JohnPattersonConsulting/DuneBuggyEFI/soupflood's 555-Based Gate Driver.jpg

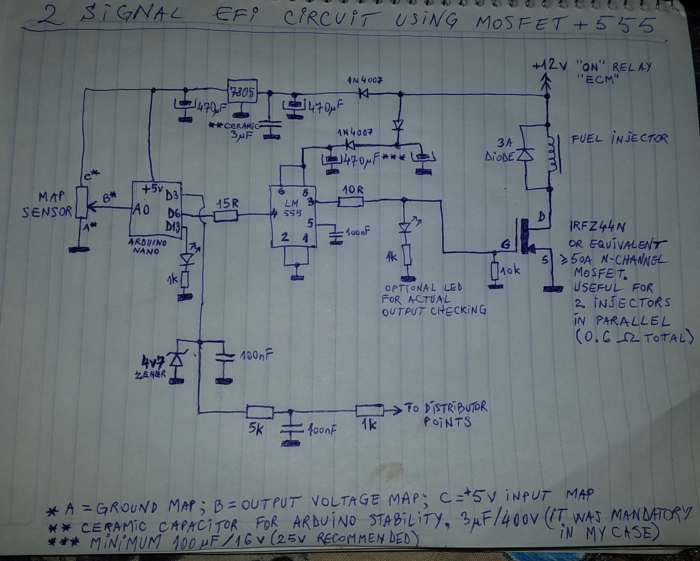
soupflood's 555-Based Gate Driver.jpg
