JohnPattersonConsulting/DuneBuggyEFI/EFI+Ignition/PCB Files/Power_Buggy_ECU_V3.1_Preview.jpg

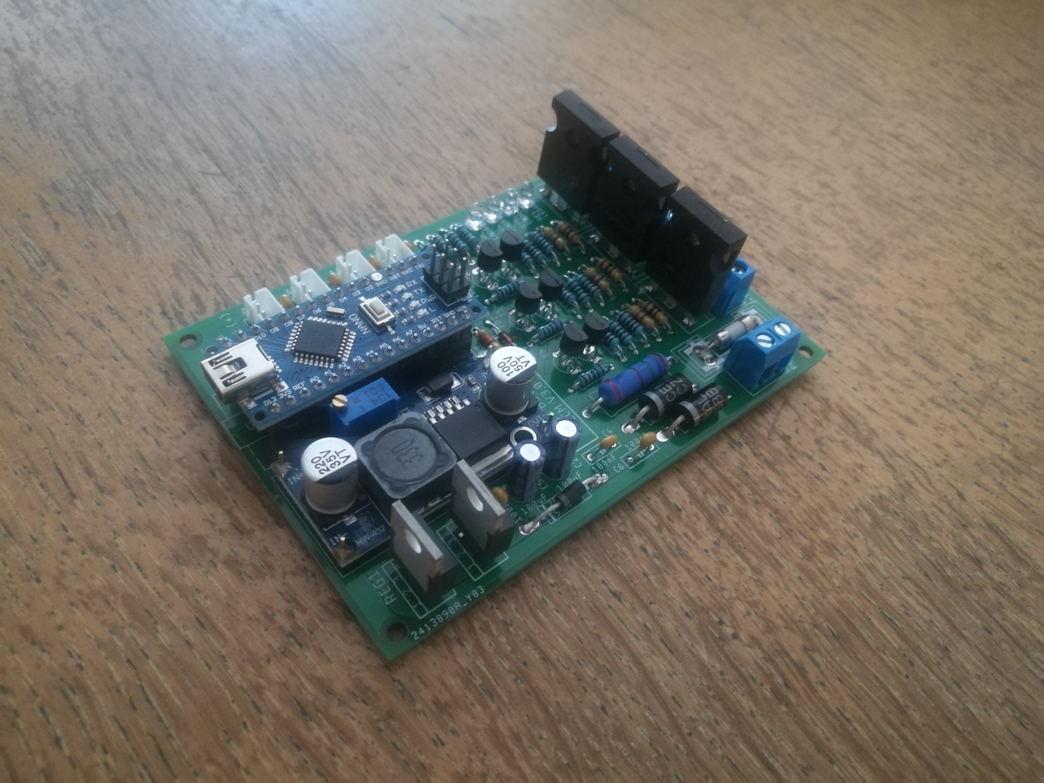
EFI+Ignition/PCB Files/Power_Buggy_ECU_V3.1_Preview.jpg
