JohnPattersonConsulting/DuneBuggyEFI/4-Coil_ECM/PCB Files/BOM_4-Coil_V1.1.xlsx

Engine Control Module Parts:
Description: | MFG Part #: | QTY:
CAP CER 0.1UF 50V Z5U RADIAL | C315C104M5U5TA7303 | 8
IC REG LINEAR 5V 1A TO220-3 | LM7805CT/NOPB | 2
CAP ALUM 100UF 20% 16V RADIAL | ESL107M016AC3AA | 2
DIODE ZENER 22V 5W AXIAL | 1N5358BG | 2
MOSFET N-CH 500V 20A TO247-3 | IRFP460 | 6
TRANS PNP 40V 0.2A TO92 | 2N3906-G | 4
T-NPN SI-GEN PUR AMP SW | 2N4401 | 4
RES 100 OHM 1/4W 5% CF MINI | CFM14JT100R | 6
RES 470 OHM 1/4W 5% AXIAL | CF14JT470R | 4
RES 1K OHM 1/4W 1% AXIAL | RNF14FTD1K00 | 23
RES 3.3K OHM 1/4W 5% AXIAL | CF14JT3K30 | 4
CONN HEADER VERT 3POS 2MM | SWR201-NRTN-S03-SA-WH | 3
DIODE ZENER 4.7V 400MW ALF2 | BZX79-C4V7,133 | 4
400KHz 60V 4A Switching Current Boost / Buck-Boost / Inverting DC/DC Converter | XL6009E1 | 1
LED BLUE CLEAR T/H | LTL1CHTBK4 | 2
LED GREEN CLEAR T-1 T/H | LTL1CHKGKNN | 2
LED RED CLEAR T-1 T/H | LTL1CHKRKNN | 2
LED YELLOW CLEAR T-1 T/H | LTL1CHKSKNN | 1
RES 10K OHM 5% 1/4W AXIAL | CF14JT10K0 | 4
DIODE ZENER 5.6V 3W AXIAL | 1N5919BG | 1
FUSE CERAMIC 8A 250VAC AXIAL | C310T-SC-8-R-TR1 | 1
ARDUINO NANO | ARDUINO NANO | 2
CAP CER 10000PF 50V X7R RADIAL | K103K10X7RF5UH5 | 4
EURO BLOCK, 2 POSITION | EBBA-02-C-SS-BU | 9
Optical Spark Board Parts:
Description: | MFG Part #: | QTY:
TRANS NPN 30V 0.8A TO18 | 2N2222 | 4
Slot PCB Photo Interrupter | HY860F | 2
RES 3.3K OHM 5% 1/4W AXIAL | CF14JT3K30 | 5
RES 470 OHM 1W 5% AXIAL | PR01000104700JR500 | 4
CAP CER 1UF 25V X5R RADIAL | FK18X5R1E105K | 1
