JohnPattersonConsulting/DuneBuggyEFI/EFI+Ignition/PCB Files/BOM_Power_Buggy_EFI_V3.1.xlsx

Engine Control Module Parts:
Description: | MFG Part #: | QTY:
CAP CER 0.1UF 50V Z5U RADIAL | C315C104M5U5TA7303 | 9
IC REG LINEAR 5V 1A TO220-3 | LM7805CT/NOPB | 2
CAP ALUM 100UF 20% 16V RADIAL | ESL107M016AC3AA | 2
DIODE ZENER 22V 5W AXIAL | 1N5358BG | 2
MOSFET N-CH 500V 20A TO247-3 | IRFP460 | 3
TRANS PNP 40V 0.2A TO92 | 2N3906-G | 3
T-NPN SI-GEN PUR AMP SW | 2N4401 | 3
RES 100 OHM 1/4W 5% CF MINI | CFM14JT100R | 3
RES 470 OHM 1/4W 5% AXIAL | CF14JT470R | 3
RES 1K OHM 1/4W 1% AXIAL | RNF14FTD1K00 | 16
RES 3.3K OHM 1/4W 5% AXIAL | CF14JT3K30 | 1
CONN HEADER VERT 3POS 2MM | SWR201-NRTN-S03-SA-WH | 4
DIODE ZENER 4.7V 400MW ALF2 | BZX79-C4V7,133 | 1
400KHz 60V 4A Switching Current Boost / Buck-Boost / Inverting DC/DC Converter | XL6009E1 | 1
RES 150 OHM 2% 2W AXIAL | RSF2GT150R | 1
LED BLUE CLEAR T/H | LTL1CHTBK4 | 1
LED GREEN CLEAR T-1 T/H | LTL1CHKGKNN | 1
LED RED CLEAR T-1 T/H | LTL1CHKRKNN | 1
LED YELLOW CLEAR T-1 T/H | LTL1CHKSKNN | 1
RES 10K OHM 5% 1/4W AXIAL | CF14JT10K0 | 1
DIODE ZENER 5.6V 3W AXIAL | 1N5919BG | 1
FUSE CERAMIC 8A 250VAC AXIAL | C310T-SC-8-R-TR1 | 1
ARDUINO NANO | ARDUINO NANO | 1
Suggested Mechanical Parts:
Description: | Source:
Fuel Injector Barb Adapter | https://www.ebay.com/itm/113711584424
440 cc/min Fuel Injectors | https://www.ebay.com/itm/223283676528
MAP Sensor | https://www.amazon.com/gp/product/B07Z37XG1J
Fuel Filter/Pressure Regulator | https://www.amazon.com/gp/product/B07W9H5TF9
Fuel Pump | https://www.amazon.com/gp/product/B07J39HNTC
Fuel Hose | https://www.amazon.com/gp/product/B00PLKV5H6
High-Energy Ignition Coil (Sold as pack of 8, but only need 1) | https://www.amazon.com/gp/product/B00EOXZLG2
