JohnPattersonConsulting/DuneBuggyEFI/4-Coil_ECM/Distributor Cover Cap/Buggy_Distributor_Cover_V1.STEP

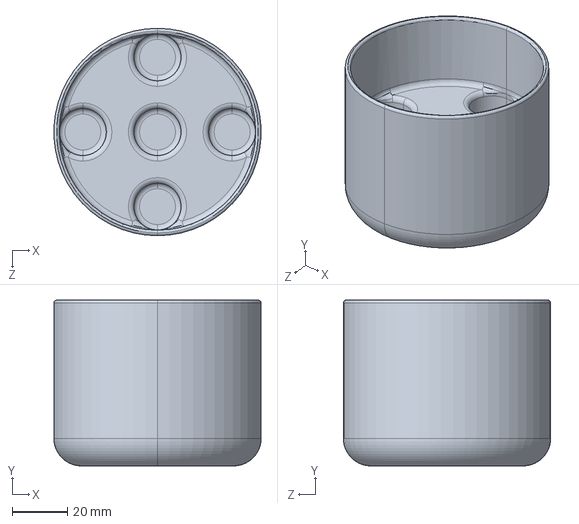
[picture p3: CAD file, 2022-07-23]
4-Coil_ECM/Distributor Cover Cap/Buggy_Distributor_Cover_V1.STEP
74.9 x 60.0 x 75.0 mm
