JohnPattersonConsulting/DuneBuggyEFI/4-Coil_ECM/Optical Rotor CAD/Optical_Rotor.STEP

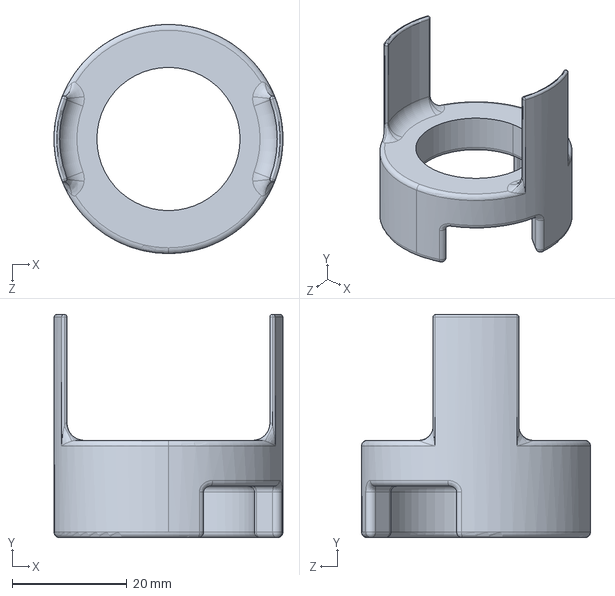
[picture p4: CAD file, 2022-06-12]
4-Coil_ECM/Optical Rotor CAD/Optical_Rotor.STEP
40.0 x 39.0 x 40.0 mm
