JohnPattersonConsulting/DuneBuggyEFI/(list of files, cad)

Other CAD files:
4-Coil_ECM/Distributor Cover Cap/Buggy_Distributor_Cover_V1.SLDPRT
4-Coil_ECM/Distributor Cover Cap/Buggy_Distributor_Cover_V1.STL
4-Coil_ECM/Optical Rotor CAD/Optical_Rotor.SLDPRT
4-Coil_ECM/Optical Rotor CAD/Optical_Rotor.STL
