JohnPattersonConsulting/DuneBuggyEFI/(threads)

Thread 2 (2022-04-26):

Piggyback mode

giannaros900, 2022-04-26:
Very good job but how about a piggyback mode for 2 cylinder RPM vs TPS vs AFR??? Would be very interested for motorcycles

soupflood, 2023-04-01:
Assuming the 2 cylinder engine is a 4 stroke, it will send 1 pulse per revolution, so modify pulsesPerRevolution = 1. "fuel_comp = 1" for regular gasoline, just remove the double dash ”//” to activate the constant and add double dash in front of the other "fuel_comp" to inactivate it.
Next, find your injector maximum flow rate in g/min and input it in "injector_Max_Grams_Per _Minute"constant. Then, choose a refresh rate for the injector in "injector_UpdateInterval". 30000 to 50000 may work okay.
In the version 2.1, TPS is emulated in the code (less wiring, less complex build) and you can choose one of the various AFR maps provided (default is "Richer at idle only").

giannaros900, 2023-04-01:
The problem with piggyback mode is when dfco is activated...the injectors are completely closed and we can't calculate rpm.... so,crankshaft position signal is necessary, that means we need 3 interrupts

soupflood, 2023-04-01:
That sounds quite a bit more complicated than the purpose of the original code. If you want to, you could learn to modify it in order to comply with the DFCO function you wish.

Thread 4 (2023-03-31):

2 signal EFI circuit using MOSFET + 555

soupflood, 2023-03-31:
I built an EFI circuit using your electronic schematic, only I used a MOSFET driven by a TL555 in the gate buffer mode.
I would like to send you the schematic I used for you to post it along with your original one, so that other people can also use it if they want. I already tested the circuit and it works okay.
Let me know what you think.
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

JohnPattersonConsulting, 2023-04-01:
This is a great idea! One suggestion I would have would be to put some kind
of regulator on the power supply of the 555, as I have blown up many 555s
by connecting them directly to the automotive 12V rail.

Are you able to submit it as a fork or commit, or do I have to upload it
directly?

Best regards,
John

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

soupflood, 2023-04-01:
I don't know yet how to upload images the way you said; and I only have the image I attached. If you think the quality is good, then please upload it next to your original schematic.
About the 555: yes, it would be ideal to feed it through a proper 12V regulator, however I don't currently have one laying around. The series double diode - parallel double capacitor seems to have done the trick so far because it still works okay. The 555 is supposed to handle up to 15V of VCC, but if it will blow up I will of course consider getting one 12V regulator installed.
I guess every car wiring is different; I rather had more problems with the Arduino stability than with the 555: had to solder a 3uF ceramic capacitor across the 5V regulator input's electrolytic capacitor, and replace the 10k resistor leading to the points with a 5k one (just soldered another 10k in parallel to it).

JohnPattersonConsulting, 2023-04-02:
Excellent, I just uploaded your design.

By the way, one thing that I found to work well was to add a piece of
copper mesh or foil over the top of the ATMega328p and its clock crystal,
and to solder this part to the USB port for grounding. After I did this,
the Arduino Nano was much more stable and gave less trouble with crashing.

I also removed the small 5V regulator on the back of the Nano, as I found
that after a couple months of driving, it randomly started short-circuiting
the 5V rail.

Best regards,
John

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

soupflood, 2023-04-02:
Thank you for uploading it.
What I found to be useful so far, was to keep all Arduino related wires at
least one inch away from any spark wires. I guess that even if I screen it
like you suggested, it will still be bothered if its wires come too close
to the high voltage parts.
As far as the on board 5v regulator...I really hope it won't go bad because
I'm not even actually using it... And I've already soldered the Arduino
board to the "mother"board.
Take care.

El sáb., 1 de abr. de 2023 8:08 p. m., JohnPattersonConsulting <
***@***.***> escribió:

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

DANAVERYOLD, 2025-09-05:
Where is the code for nano is one of the listed
