JohnPattersonConsulting/DuneBuggyEFI/4-Coil_ECM/PCB Files/Optical_Spark_V2.0/Optical_Spark_V2.0.brd

## EAGLE design 4-Coil_ECM/PCB Files/Optical_Spark_V2.0/Optical_Spark_V2.0.brd (2022-05-30)

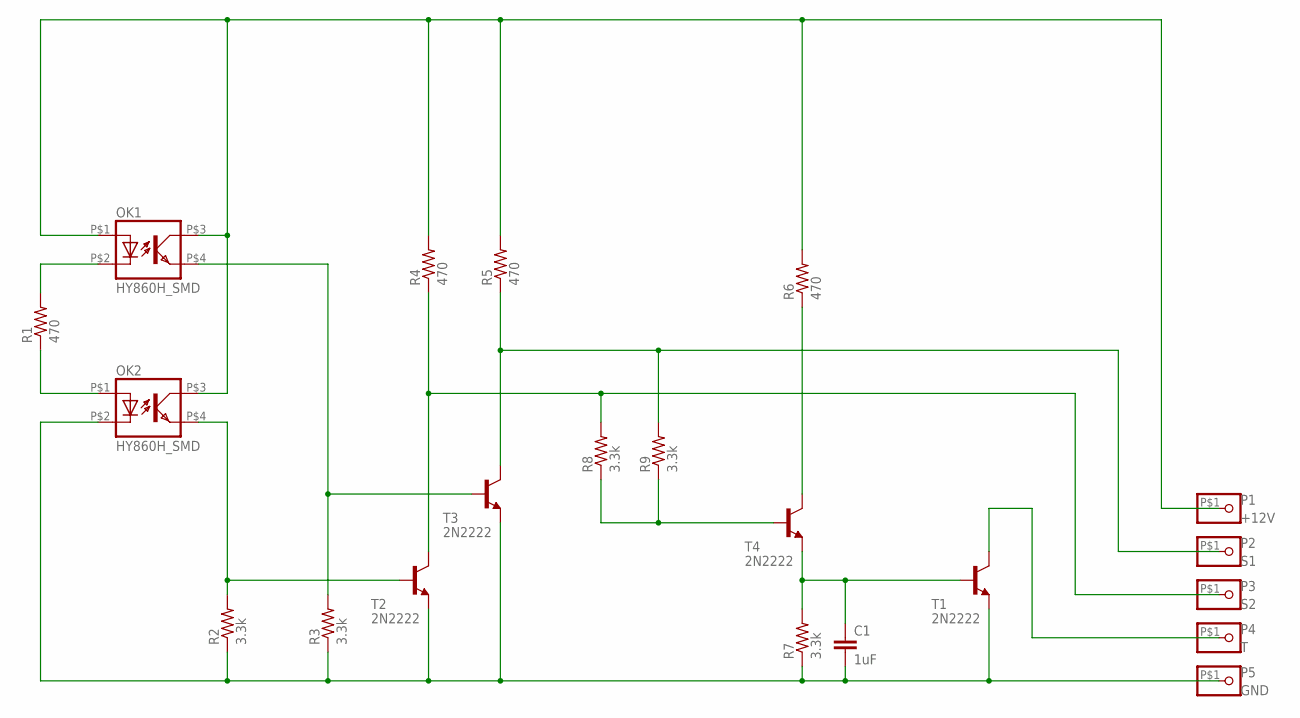
[picture p5: schematic Optical_Spark_V2.0.sch]

Parts:
C1: 1uF; SMALLCAP_THT_SMD
OK1, OK2: HY860H_SMD
P1: +12V; PAD
P2: S1; PAD
P3: S2; PAD
P4: T; PAD
P5: GND; PAD
R1, R4, R5, R6: 470; 0.25W_THT_SMD
R2, R3, R7, R8, R9: 3.3k; 0.25W_THT_SMD_SMALL
T1, T2, T3, T4: 2N2222; NPN_THT_SMD_EBC

Connections:
unnamed: OK1.P$2 (C), R1.P$2 (2)
unnamed: OK2.P$1 (A), R1.P$1 (1)
unnamed: C1.P$2 (2), OK2.P$2 (C), P5.P$1, R2.P$1 (1), R3.P$1 (1), R7.P$1 (1), T1.P$1 (E), T2.P$1 (E), T3.P$1 (E)
unnamed: OK1.P$1 (A), OK1.P$3 (COL), OK2.P$3 (COL), P1.P$1, R4.P$2 (2), R5.P$2 (2), R6.P$2 (2)
unnamed: C1.P$1 (1), R7.P$2 (2), T1.P$2 (B), T4.P$1 (E)
unnamed: OK2.P$4 (EMIT), R2.P$2 (2), T2.P$2 (B)
unnamed: OK1.P$4 (EMIT), R3.P$2 (2), T3.P$2 (B)
unnamed: P2.P$1, R5.P$1 (1), R9.P$2 (2), T3.P$3 (C)
unnamed: P3.P$1, R4.P$1 (1), R8.P$2 (2), T2.P$3 (C)
unnamed: R6.P$1 (1), T4.P$3 (C)
unnamed: P4.P$1, T1.P$3 (C)
unnamed: R8.P$1 (1), R9.P$1 (1), T4.P$2 (B)

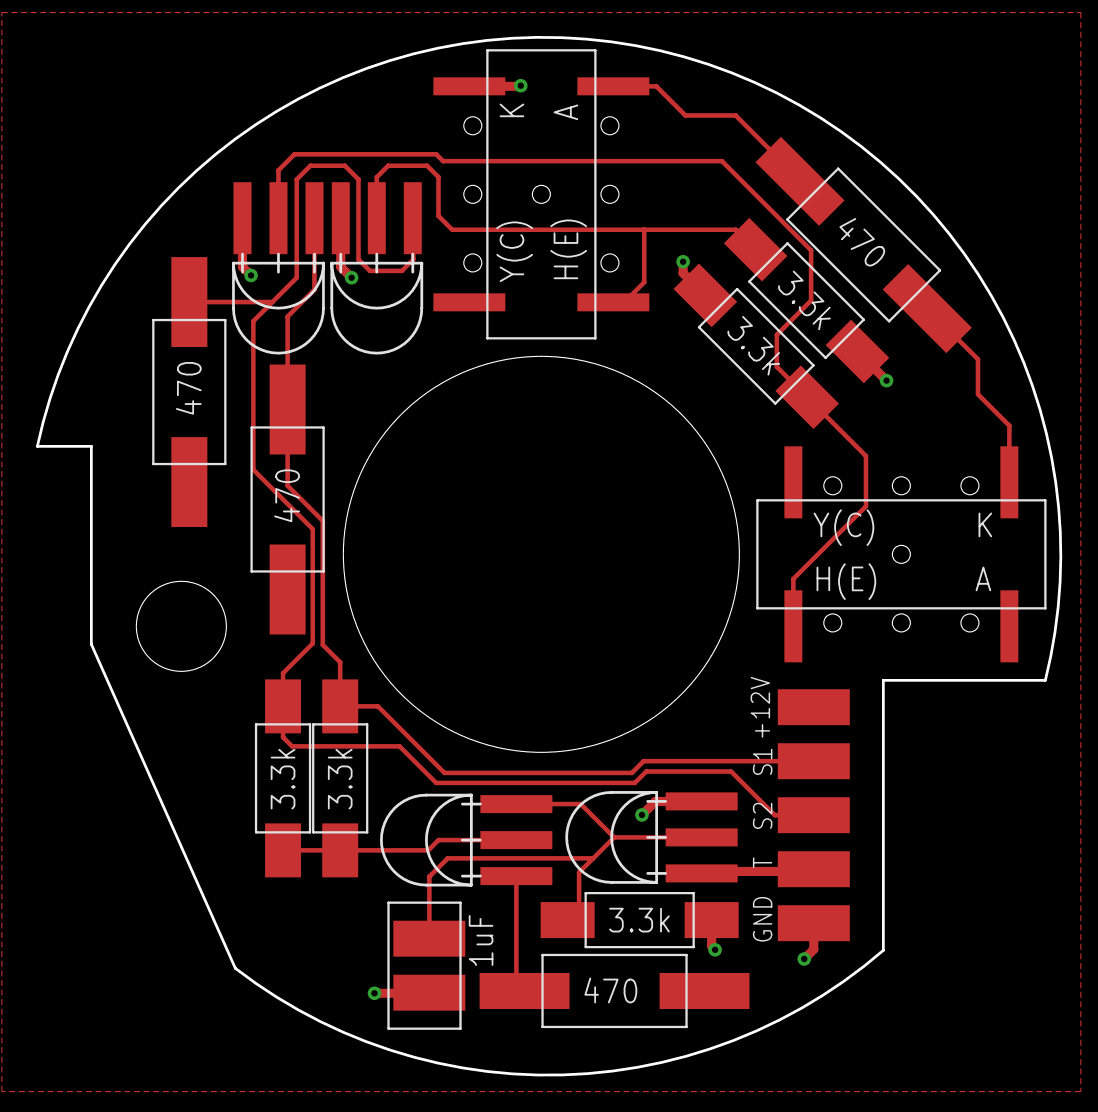
[picture p6: board Optical_Spark_V2.0.brd from above]

Board: 2 copper layers, 56.9 x 57.6 mm, 21 parts (0 on the bottom side), 12 nets.
