JohnPattersonConsulting/DuneBuggyEFI/4-Coil_ECM/PCB Files/Power_Buggy_4-Coil_V1.1/Power_Buggy_4Coil_V1.1.brd

## EAGLE design 4-Coil_ECM/PCB Files/Power_Buggy_4-Coil_V1.1/Power_Buggy_4Coil_V1.1.brd (2022-05-30)

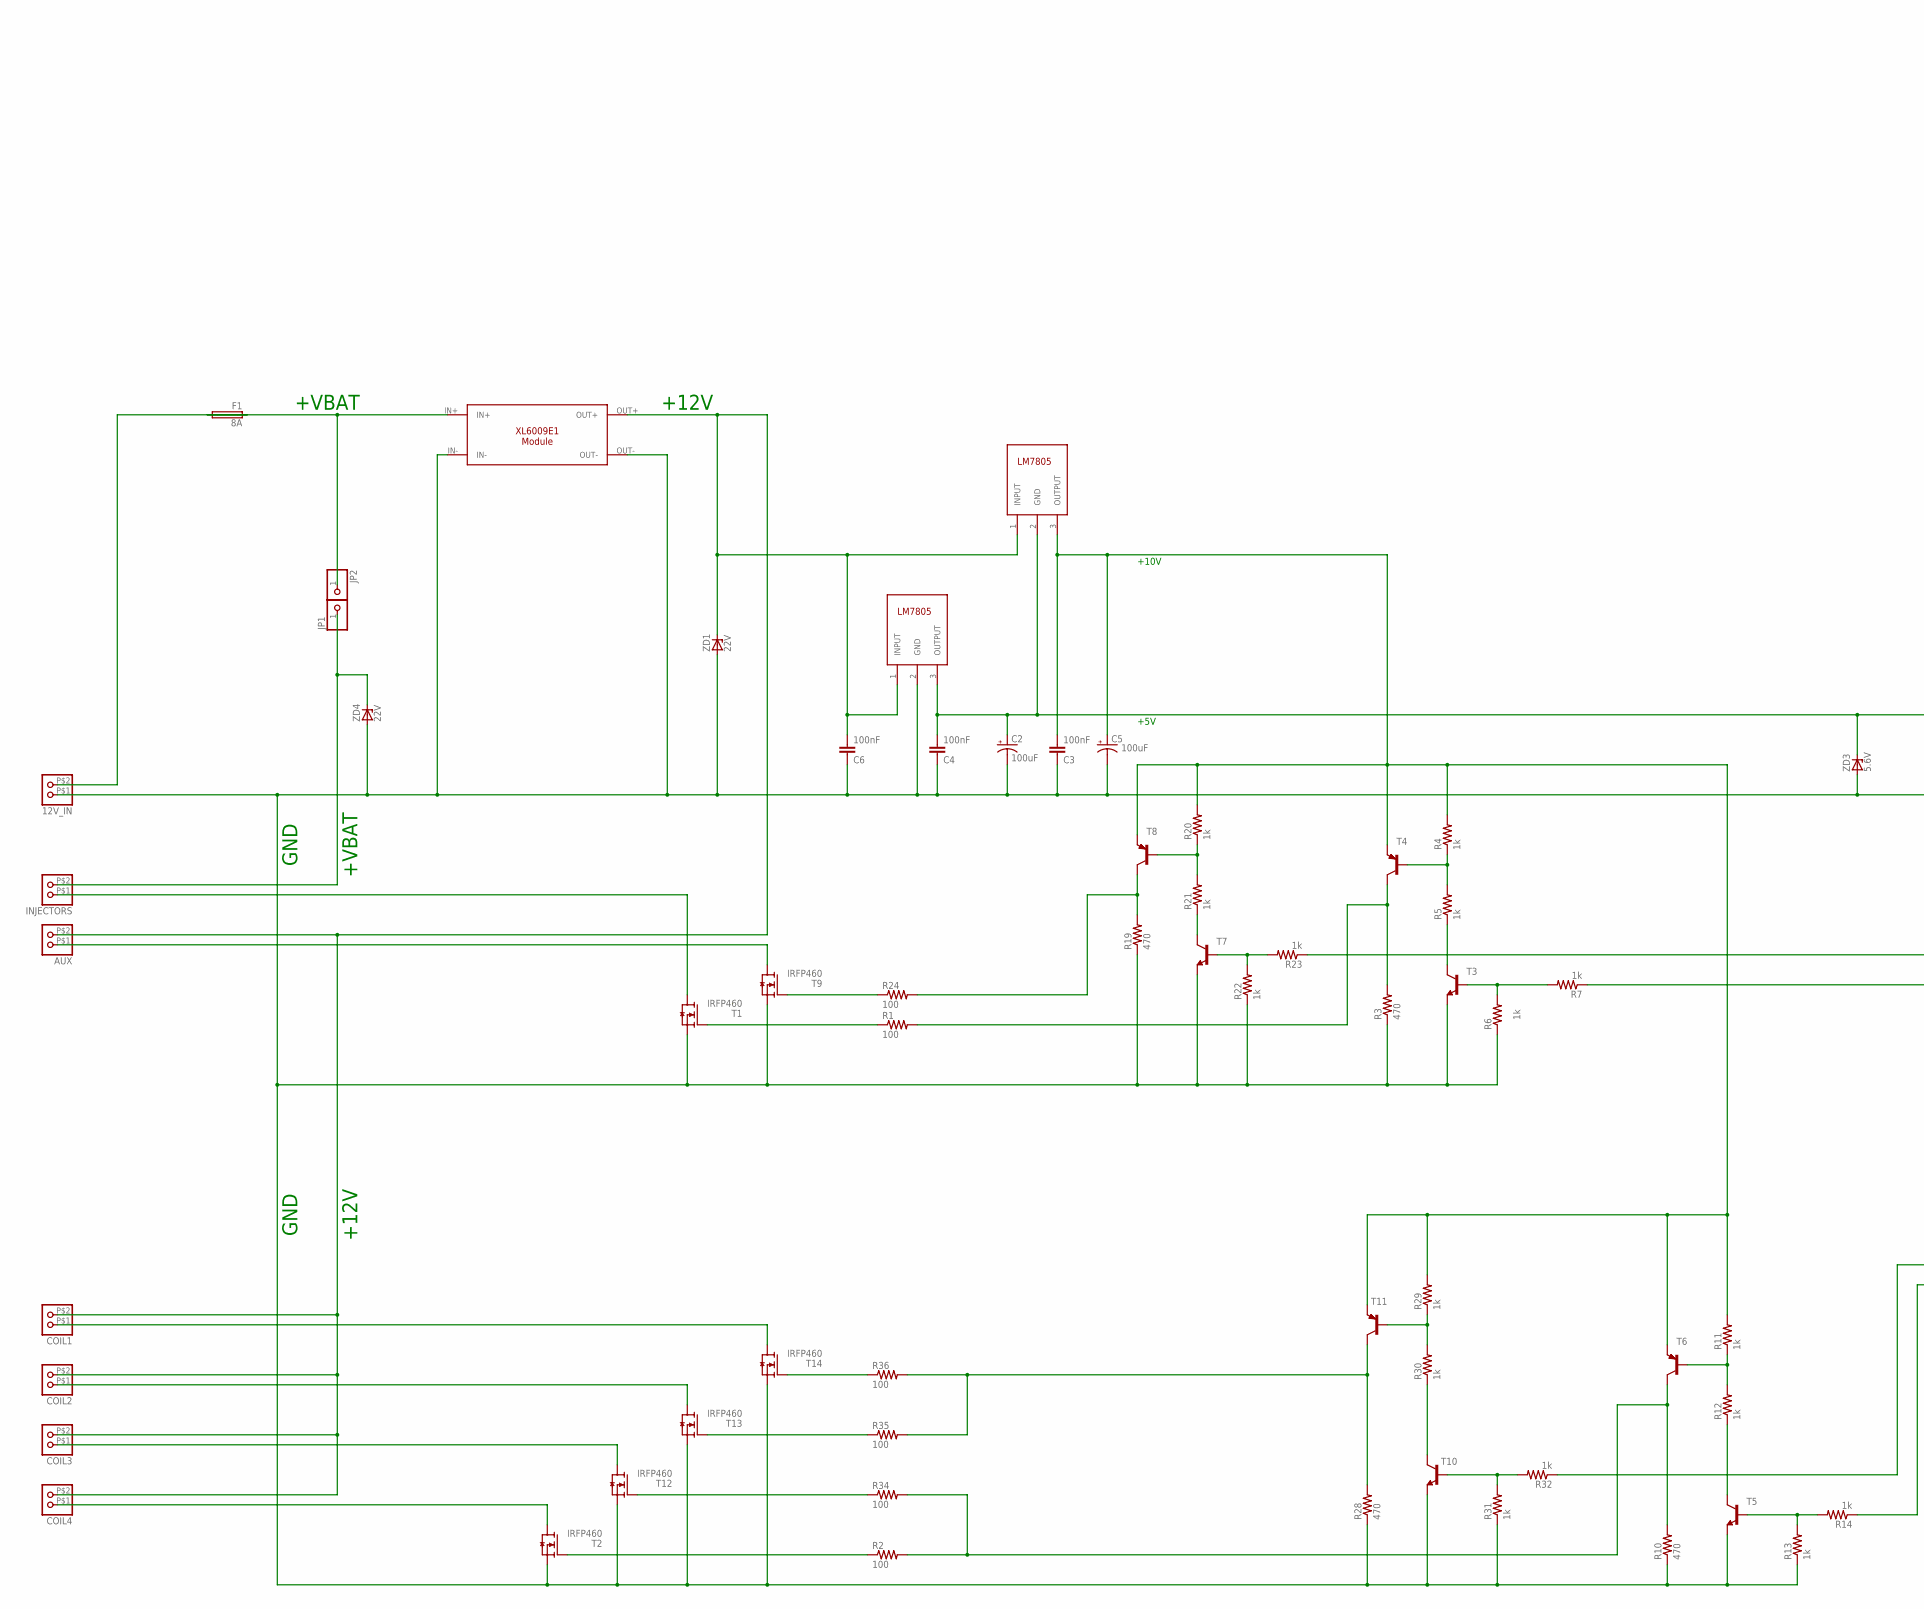
[picture p7: schematic Power_Buggy_4Coil_V1.1.sch, part in row 1, column 1]

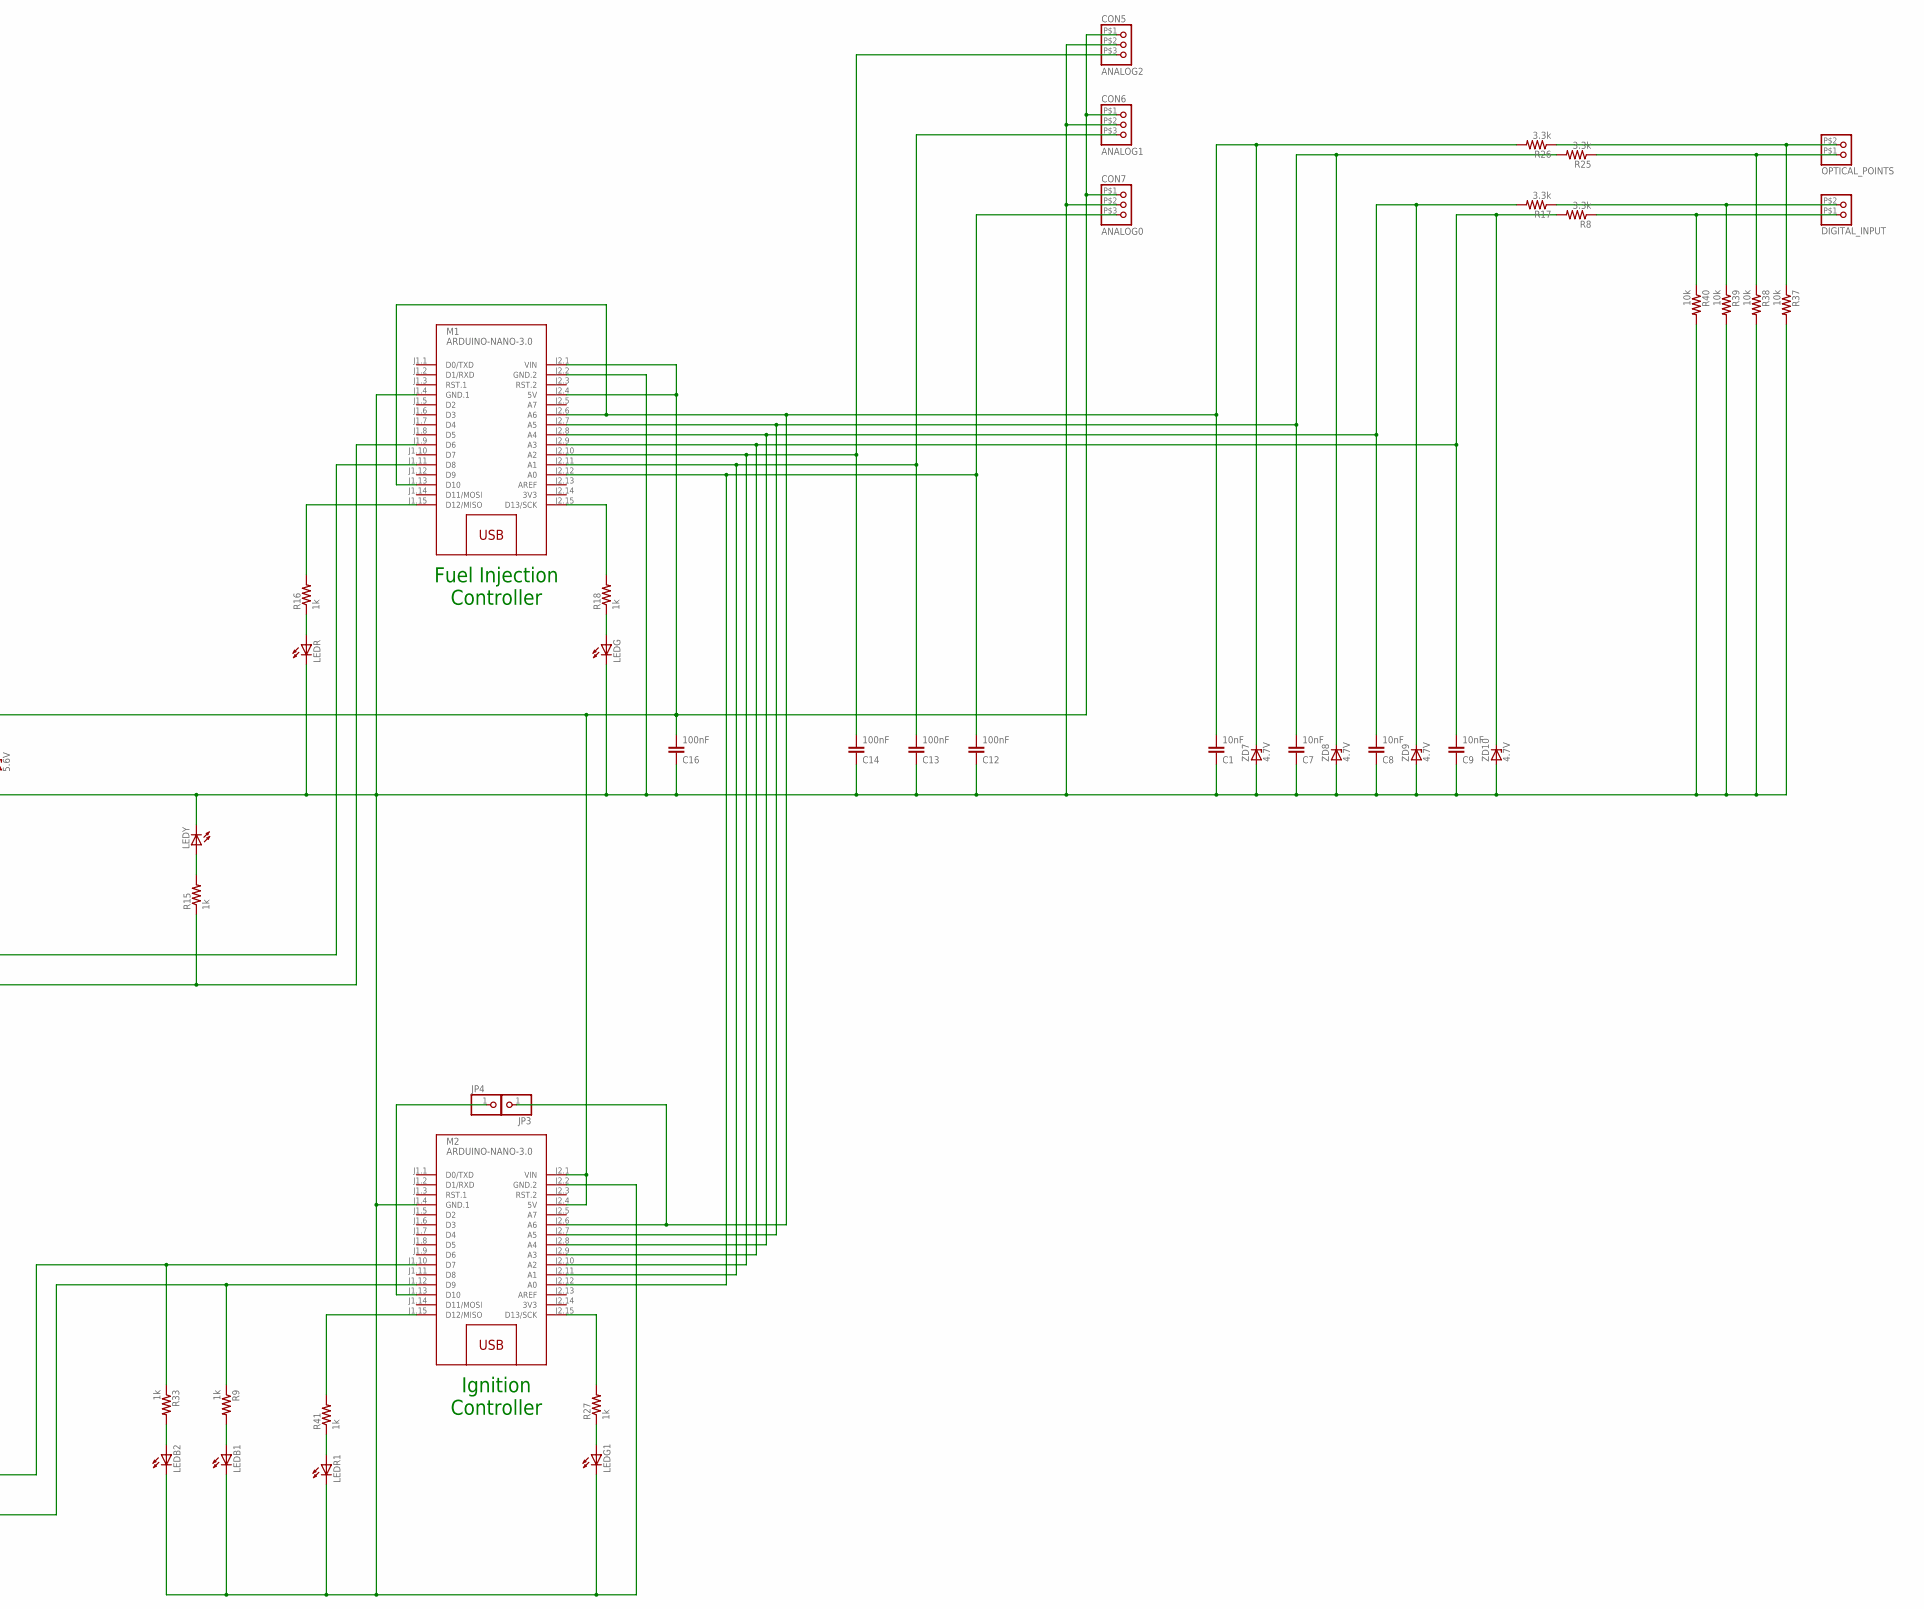
[picture p8: schematic Power_Buggy_4Coil_V1.1.sch, part in row 1, column 2]

Parts:
12V_IN: EBBA-02-C-SS-BU
AUX: EBBA-02-C-SS-BU
C1, C7, C8, C9: 10nF; C050-025X075
C2, C5: 100uF; E2-5
C3, C4, C6, C12, C13, C14, C16: 100nF; C050-025X075
COIL1, COIL2, COIL3, COIL4: EBBA-02-C-SS-BU
CON5: ANALOG2; 2.0MM_X3
CON6: ANALOG1; 2.0MM_X3
CON7: ANALOG0; 2.0MM_X3
DIGITAL_INPUT: EBBA-02-C-SS-BU
F1: 8A; GSH15
INJECTORS: EBBA-02-C-SS-BU
JP1, JP2, JP3, JP4: PINHD-1X1; 1X01
LEDB1, LEDB2: LED3MM
LEDG, LEDG1: LED3MM
LEDR, LEDR1: LED3MM
LEDY: LED3MM
M1, M2: ARDUINO-NANO-3.0
OPTICAL_POINTS: EBBA-02-C-SS-BU
R1, R2, R24, R34, R35, R36: 100; 0207/10
R3, R10, R19, R28: 470; 0207/10
R4, R5, R6, R7, R9, R11, R12, R13, R14, R15, R16, R18, R20, R21, R22, R23, R27, R29, R30, R31, R32, R33, R41: 1k; 0207/10
R8, R17, R25, R26: 3.3k; 0207/10
R37, R38, R39, R40: 10k; 0207/10
REG1, REG2: LM7805_VERT; TO220_VERT
T1, T2, T9, T12, T13, T14: IRFP460; TO-247_HORIZONTAL
T3, T5, T7, T10: -NPN-TO92-EBC; TO92-EBC
T4, T6, T8, T11: BCX58-PNP-TO92-EBC; TO92-EBC
U$2: XL6009E1_MOD
ZD1, ZD4: 22V; C1702-15
ZD3: 5.6V; C1702-15
ZD7, ZD8, ZD9, ZD10: 4.7V; DO41Z10

Connections:
3V3: M1.J2.14 (3V3), M2.J2.14 (3V3)
unnamed: R19.2, R24.2, T8.C
unnamed: AUX.P$2 (2), C6.2, COIL1.P$2 (2), COIL2.P$2 (2), COIL3.P$2 (2), COIL4.P$2 (2), REG1.1 (INPUT), REG2.1 (INPUT), U$2.OUT+, ZD1.C
unnamed: 12V_IN.P$1 (1), C1.1, C2.-, C3.1, C4.1, C5.-, C6.1, C7.1, C8.1, C9.1, C12.1, C13.1, C14.1, C16.1, CON5.P$2 (2), CON6.P$2 (2), CON7.P$2 (2), LEDB1.K (C), LEDB2.K (C), LEDG.K (C), LEDG1.K (C), LEDR.K (C), LEDR1.K (C), LEDY.K (C), M1.J1.4 (GND.1), M1.J2.2 (GND.2), M2.J1.4 (GND.1), M2.J2.2 (GND.2), R3.1, R6.1, R10.1, R13.1, R19.1, R22.1, R28.1, R31.1, R37.2, R38.2, R39.2, R40.2, REG1.2 (GND), T1.S, T2.S, T3.E, T5.E, T7.E, T9.S, T10.E, T12.S, T13.S, T14.S, U$2.IN-, U$2.OUT-, ZD1.A, ZD3.A, ZD4.A, ZD7.A, ZD8.A, ZD9.A, ZD10.A
unnamed: C2.+, C4.2, C16.2, CON5.P$1 (1), CON6.P$1 (1), CON7.P$1 (1), M1.J2.1 (VIN), M1.J2.4 (5V), M2.J2.1 (VIN), M2.J2.4 (5V), REG1.3 (OUTPUT), REG2.2 (GND), ZD3.C
unnamed: INJECTORS.P$1 (1), T1.D
unnamed: C3.2, C5.+, R4.2, R11.2, R20.2, R29.2, REG2.3 (OUTPUT), T4.E, T6.E, T8.E, T11.E
unnamed: R28.2, R35.2, R36.2, T11.C
unnamed: R2.1, T2.G
unnamed: R1.1, T1.G
unnamed: R1.2, R3.2, T4.C
unnamed: R5.1, T3.C
unnamed: R6.2, R7.2, T3.B
unnamed: R4.1, R5.2, T4.B
unnamed: M1.J1.9 (D6), R7.1, R15.1
unnamed: R20.1, R21.2, T8.B
unnamed: R29.1, R30.2, T11.B
unnamed: INJECTORS.P$2 (2), JP1.1, ZD4.C
unnamed: F1.2, JP2.1, U$2.IN+
unnamed: R2.2, R10.2, R34.2, T6.C
unnamed: M1.J1.15 (D12/MISO), R16.2
unnamed: R11.1, R12.2, T6.B
unnamed: 12V_IN.P$2 (2), F1.1
unnamed: R12.1, T5.C
unnamed: LEDR.A, R16.1
unnamed: M1.J2.15 (D13/SCK), R18.2
unnamed: LEDG.A, R18.1
unnamed: C9.2, M1.J2.9 (A3), M2.J2.9 (A3), R8.2, ZD10.C
unnamed: OPTICAL_POINTS.P$1 (1), R25.1, R38.1
unnamed: LEDY.A, R15.2
unnamed: LEDB1.A, R9.2
unnamed: R21.1, T7.C
unnamed: R22.2, R23.2, T7.B
unnamed: C12.2, CON7.P$3 (3), M1.J2.12 (A0), M2.J2.12 (A0)
unnamed: R13.2, R14.2, T5.B
unnamed: M1.J1.11 (D8), R23.1
unnamed: C13.2, CON6.P$3 (3), M1.J2.11 (A1), M2.J2.11 (A1)
unnamed: R24.1, T9.G
unnamed: AUX.P$1 (1), T9.D
unnamed: C8.2, M1.J2.8 (A4), M2.J2.8 (A4), R17.2, ZD9.C
unnamed: C7.2, M1.J2.7 (A5), M2.J2.7 (A5), R25.2, ZD8.C
unnamed: C1.2, JP3.1, M1.J1.13 (D10), M1.J2.6 (A6), M2.J2.6 (A6), R26.2, ZD7.C
unnamed: OPTICAL_POINTS.P$2 (2), R26.1, R37.1
unnamed: DIGITAL_INPUT.P$1 (1), R8.1, R40.1
unnamed: DIGITAL_INPUT.P$2 (2), R17.1, R39.1
unnamed: M2.J2.15 (D13/SCK), R27.2
unnamed: LEDG1.A, R27.1
unnamed: R30.1, T10.C
unnamed: R31.2, R32.2, T10.B
unnamed: C14.2, CON5.P$3 (3), M1.J2.10 (A2), M2.J2.10 (A2)
unnamed: M2.J1.10 (D7), R32.1, R33.1
unnamed: LEDB2.A, R33.2
unnamed: M2.J1.12 (D9), R9.1, R14.1
unnamed: R34.1, T12.G
unnamed: R35.1, T13.G
unnamed: R36.1, T14.G
unnamed: COIL4.P$1 (1), T2.D
unnamed: COIL3.P$1 (1), T12.D
unnamed: COIL2.P$1 (1), T13.D
unnamed: COIL1.P$1 (1), T14.D
unnamed: M2.J1.15 (D12/MISO), R41.2
unnamed: LEDR1.A, R41.1
unnamed: JP4.1, M2.J1.13 (D10)

Notes on the sheet:
+10V
+5V
Fuel Injection Controller
Ignition Controller
+12V
GND
+VBAT

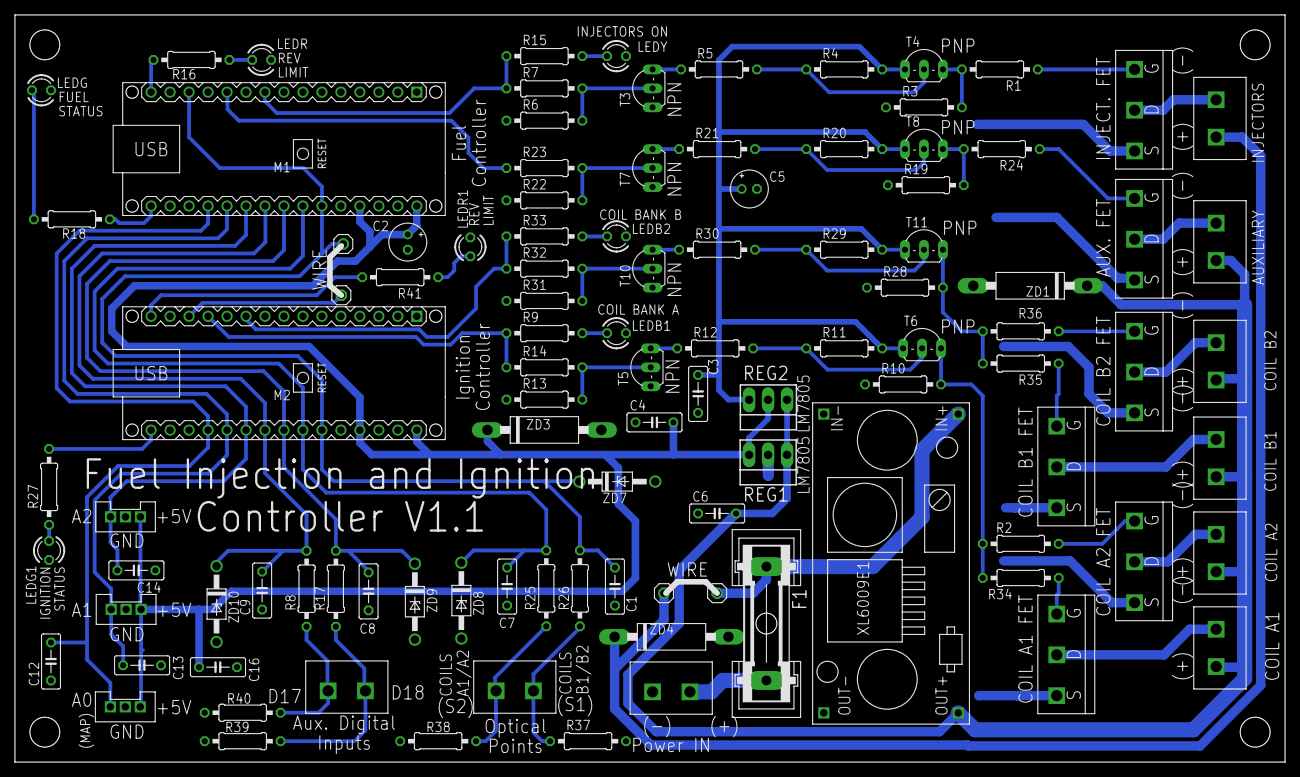
[picture p9: board Power_Buggy_4Coil_V1.1.brd from above]

Board: 1 copper layer, 170.0 x 100.0 mm, 104 parts (0 on the bottom side), 63 nets.
