JohnPattersonConsulting/DuneBuggyEFI/(commit log)

2020-12-21 Uploaded 2-sensor EFI files V1.0
    Uploaded 2-sensor EFI files V1.0 including Arduino program and hand-sketched schematic of hardware.
2021-05-13 Updated MAP_EFI_V2 to MAP_EFI_V2.1
    Fixed reversed order of parameters in call to AFR(), as kindly pointed out by Dany Ravikovitch on YouTube. Thank you!
    [MAP_EFI_V2.1.ino]
2022-02-10 Added new files for EFI+Ignition PCB and control code.
    [BOM_Power_Buggy_EFI_V3.1.xlsx, Power_Buggy_EFI_V3.1.brd, Power_Buggy_EFI_V3.1.sch]
2022-02-11 Updated injector update interval to 30ms for better fuel mixture homogeneity. Revert to 50000 if your injectors have problems at low duty cycle..
    [MAP_EFI_V2.1.ino]
2022-02-11 Added a picture of the PCB for reference.
2022-03-13 Updated BOM to include mechanical parts.
    [BOM_Power_Buggy_EFI_V3.1.xlsx]
2022-03-13 Updated silkscreen on PCB Gerber files.
2022-03-17 Removed unnecessary inductor in BOM
    [BOM_Power_Buggy_EFI_V3.1.xlsx]
2022-05-30 Added files for new 4-coil ECM system.
    [BOM_4-Coil_V1.1.xlsx, Optical_Spark_V2.0.brd, Optical_Spark_V2.0.sch, Power_Buggy_4Coil_V1.1.brd, Power_Buggy_4Coil_V1.1.sch]
2022-06-12 Contributed optical rotor CAD files
    [Optical_Rotor.SLDPRT, Optical_Rotor.STEP, Optical_Rotor.STL]
2022-07-23 Added distributor cover cap CAD files.
    [Buggy_Distributor_Cover_V1.SLDPRT, Buggy_Distributor_Cover_V1.STEP, Buggy_Distributor_Cover_V1.STL]
2023-04-02 Added a 555-based gate driver design by soupflood.
